deletedcookie/shek/shek_l/plots/shek-B_Fab.pdf

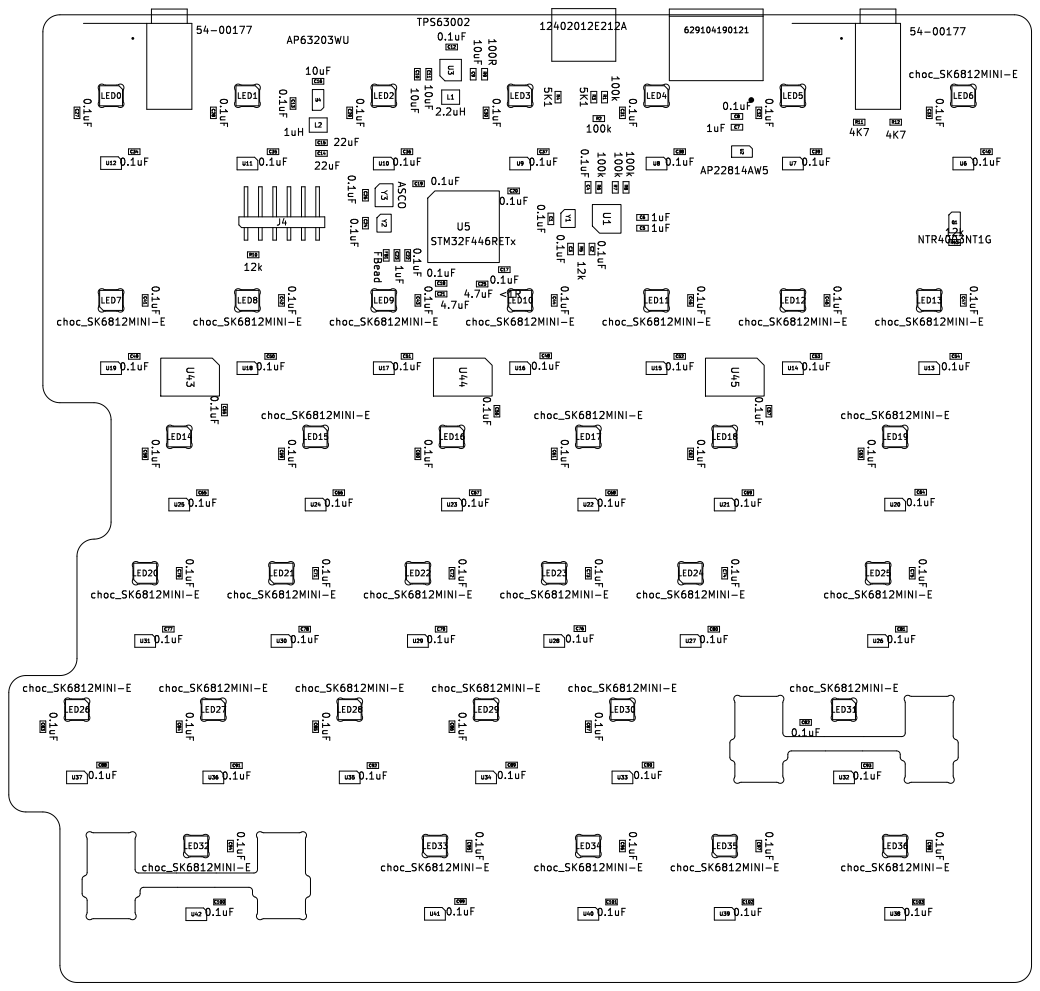
[picture p1: page 1]
