deletedcookie/shek/shek_r/plots/shek-rounded-B_Fab.pdf

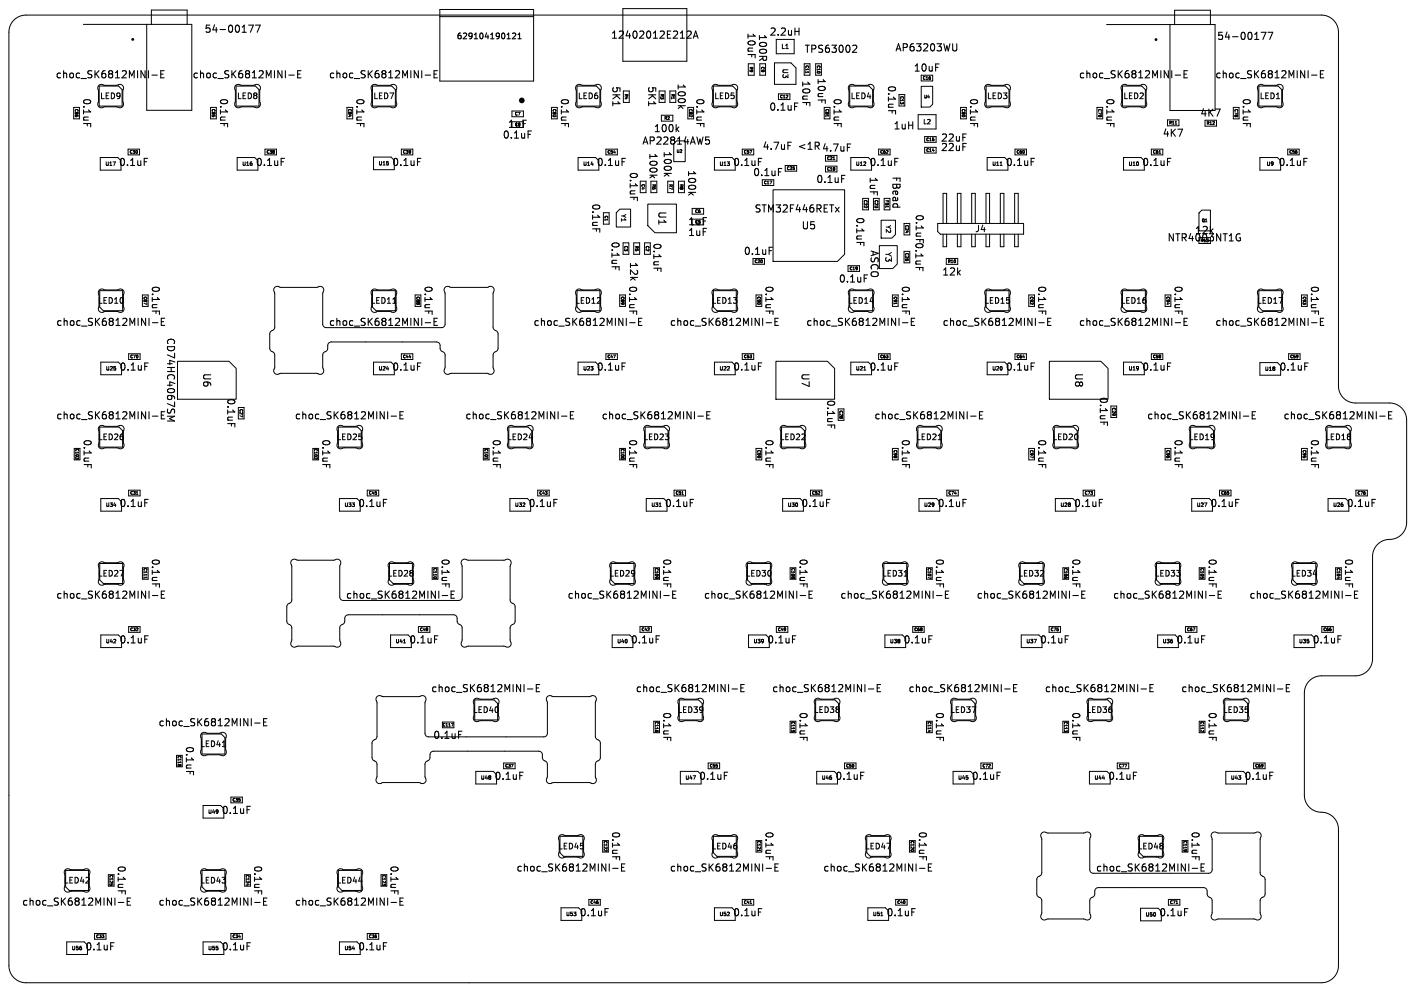
[picture p2: page 1]
