deletedcookie/shek/shek_r/plots/shek-rounded-Edge_Cuts.pdf

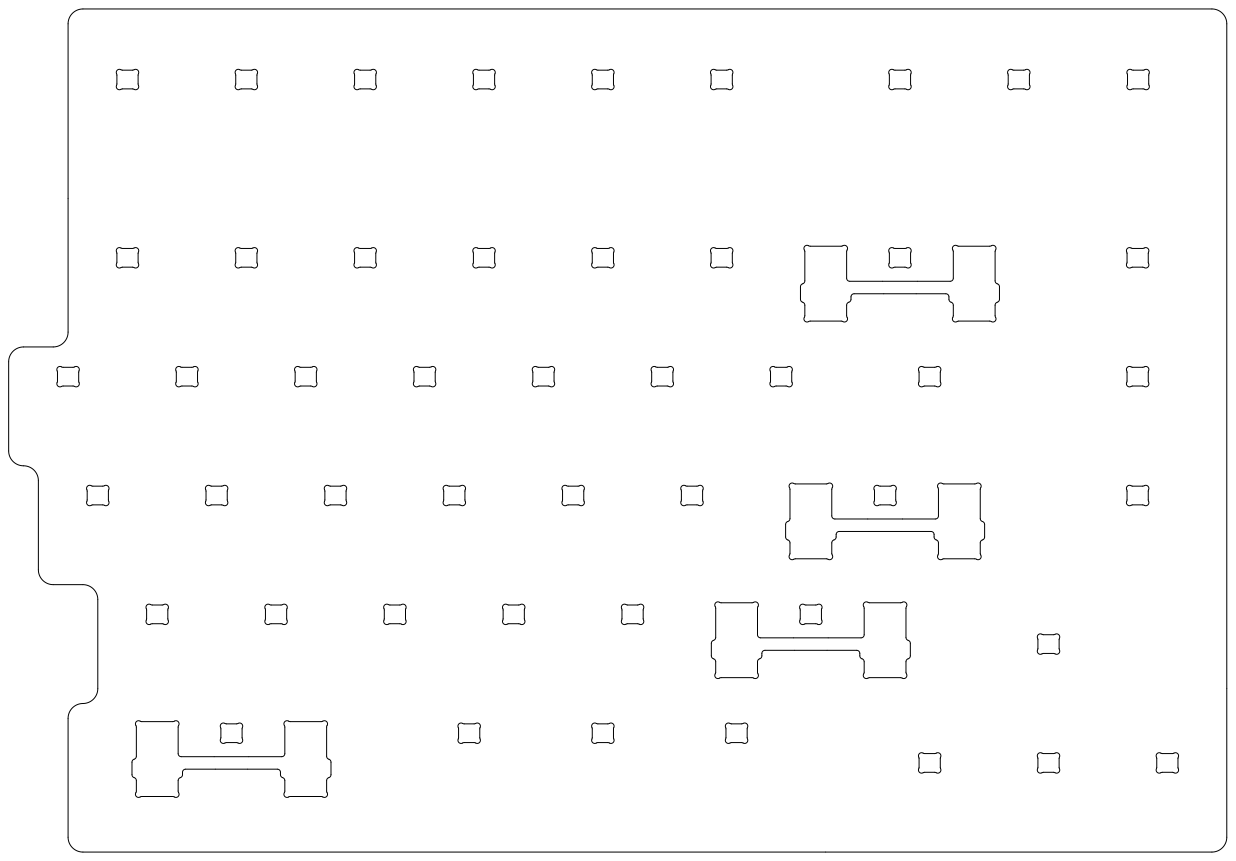
[picture p3: page 1]
