deletedcookie/shek/shek_l/shek.kicad_pcb

## KiCad design shek_l/shek.kicad_pcb (2025-09-28)

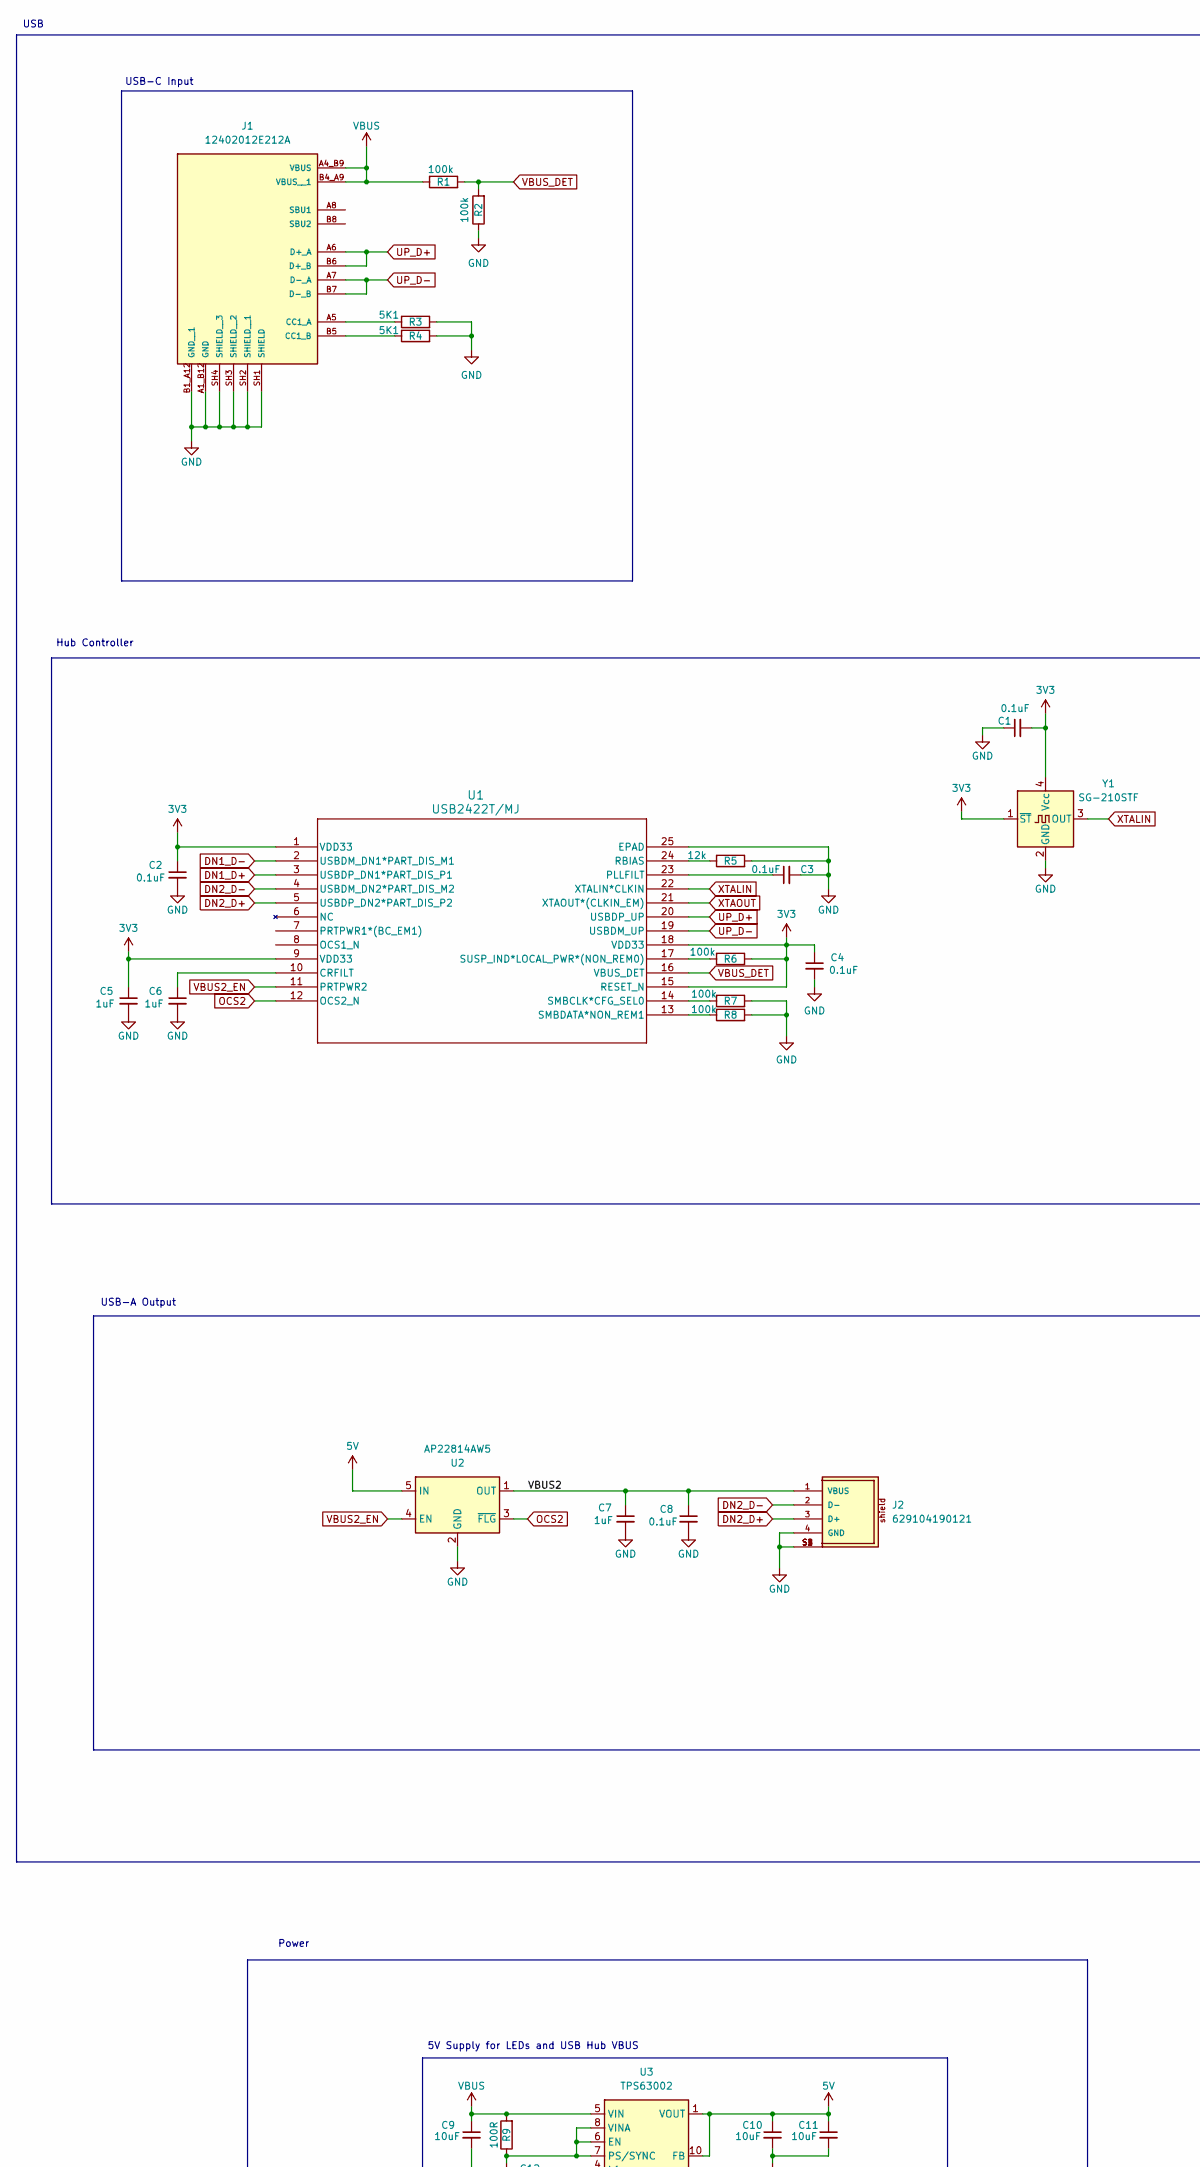
[picture p4: schematic shek.kicad_sch, part in row 1, column 1]

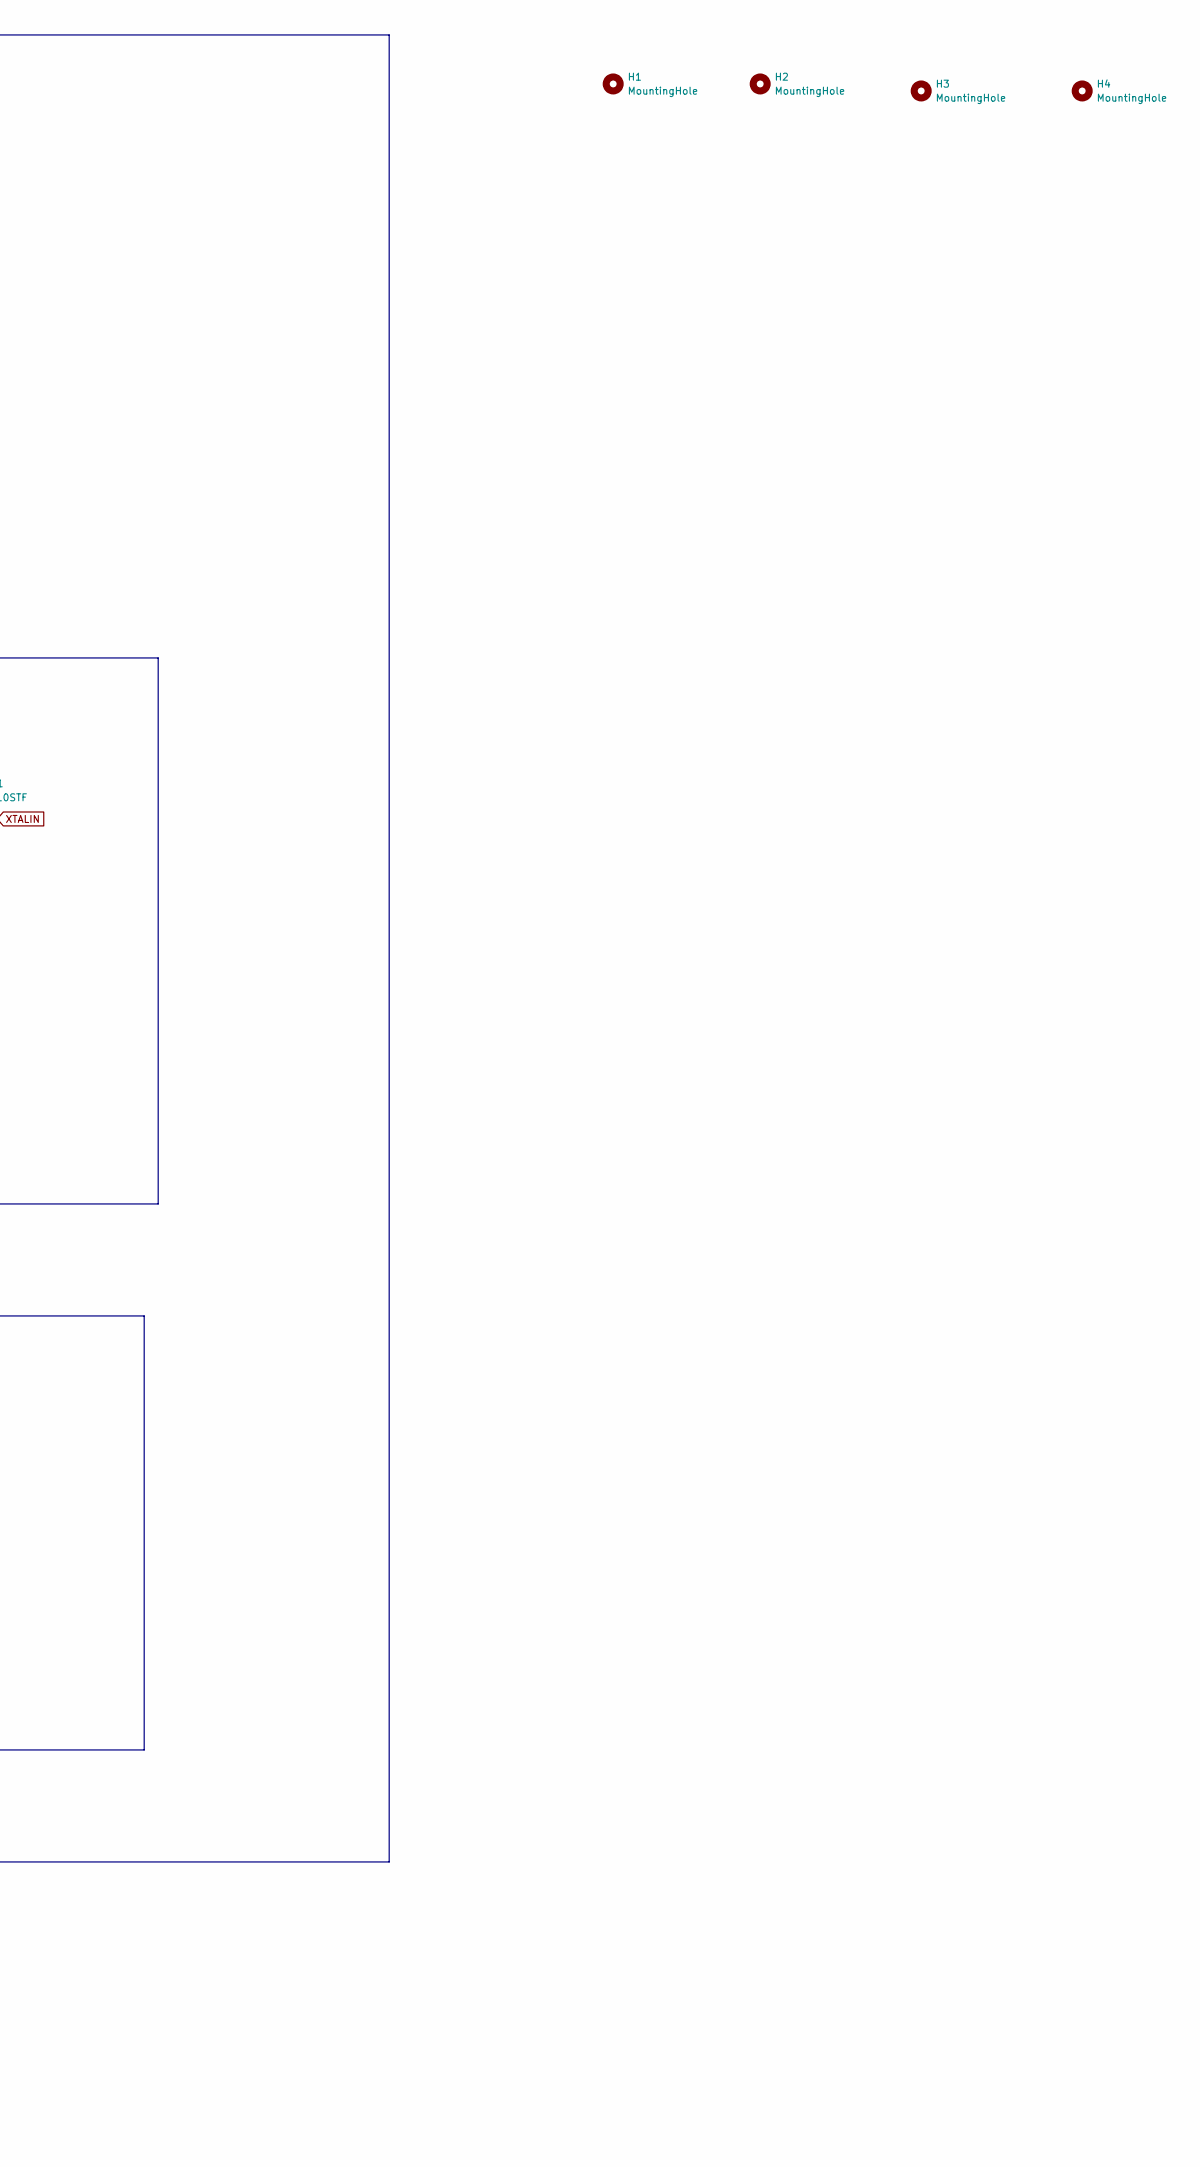
[picture p5: schematic shek.kicad_sch, part in row 1, column 2]

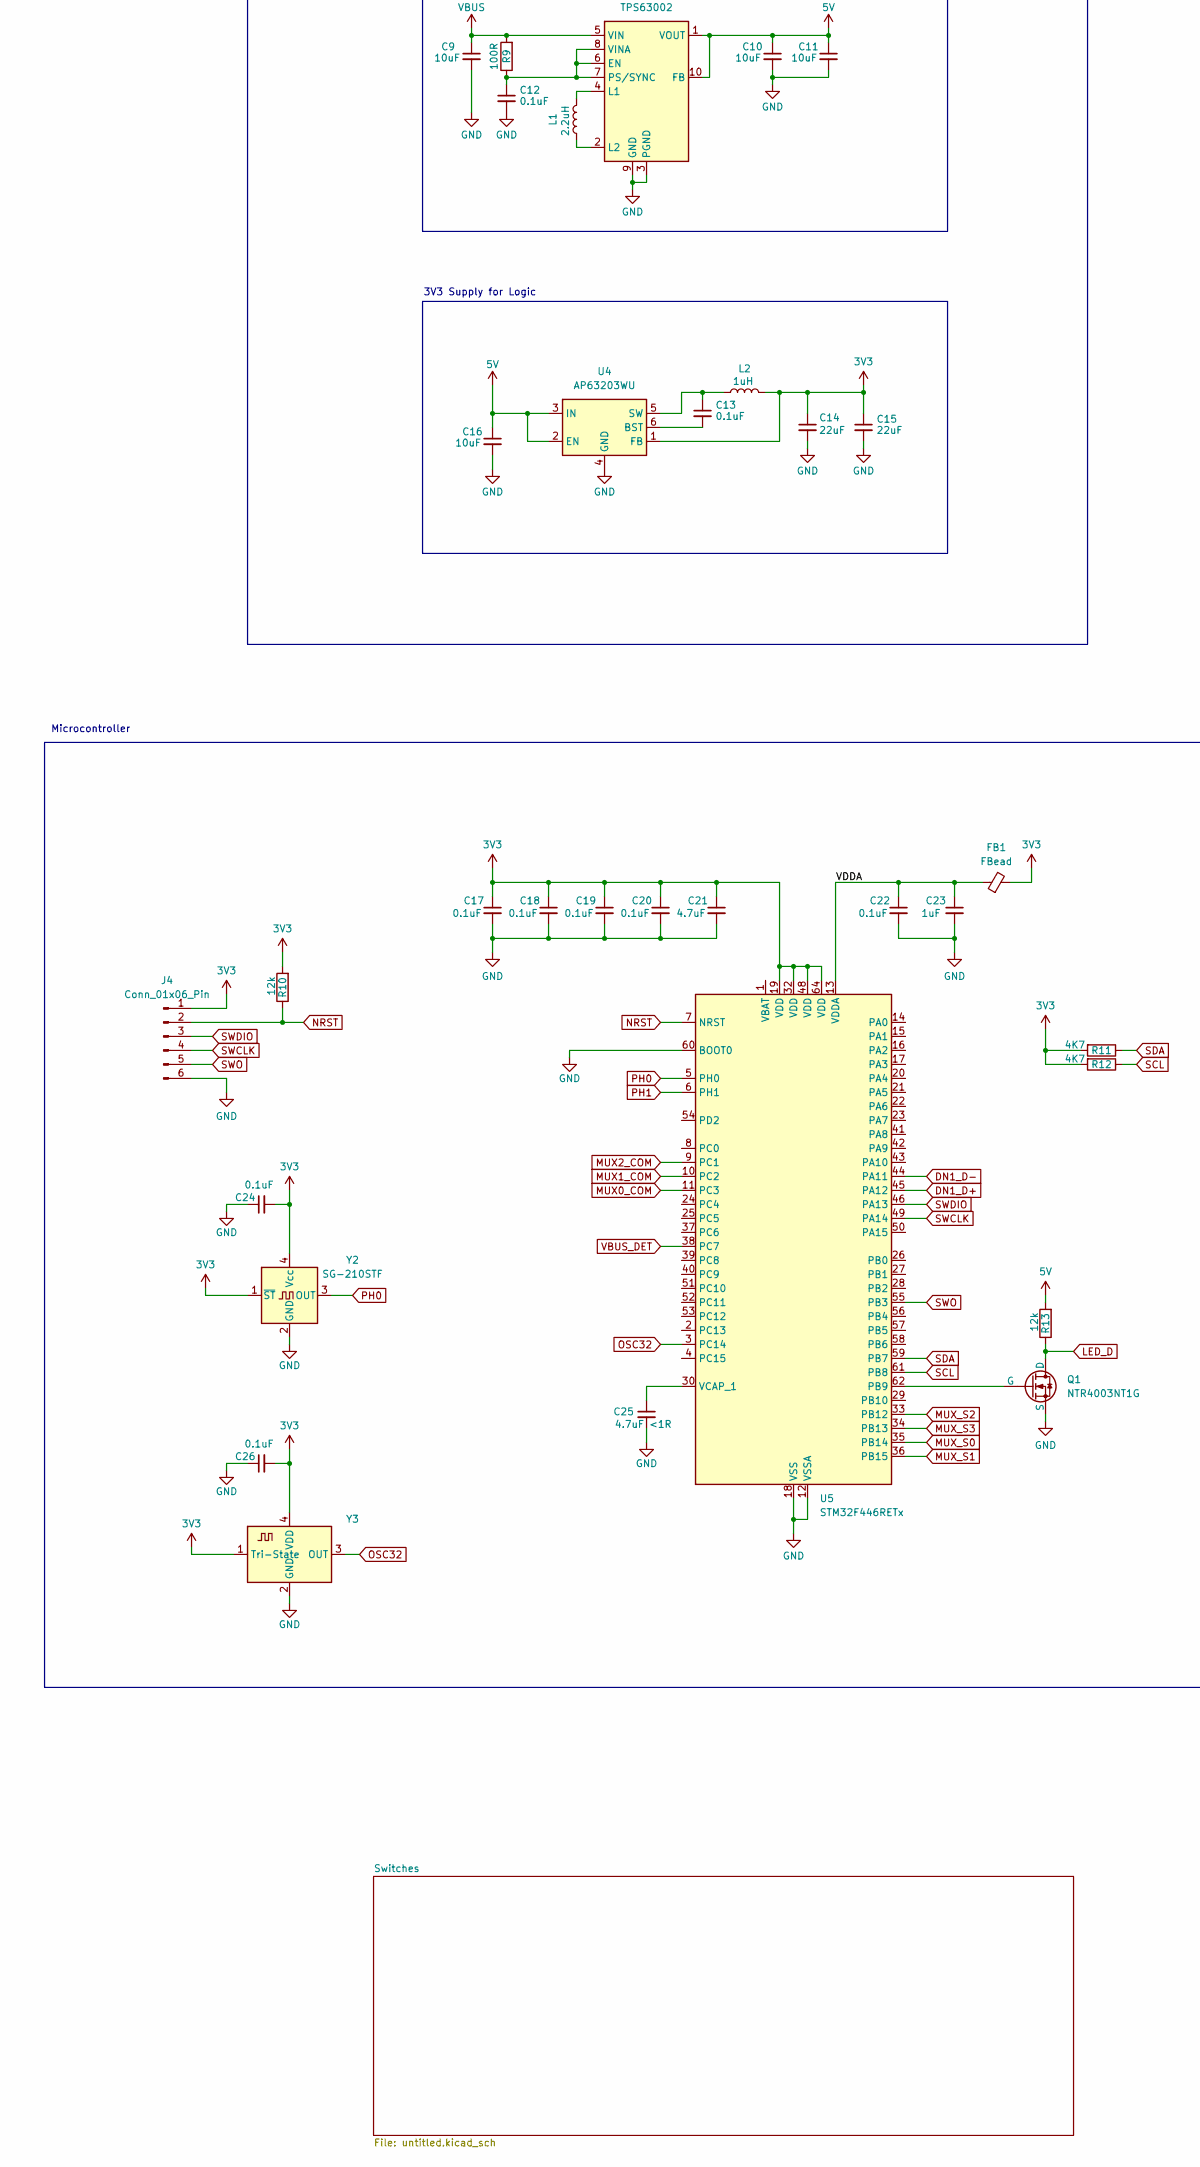
[picture p6: schematic shek.kicad_sch, part in row 2, column 1]

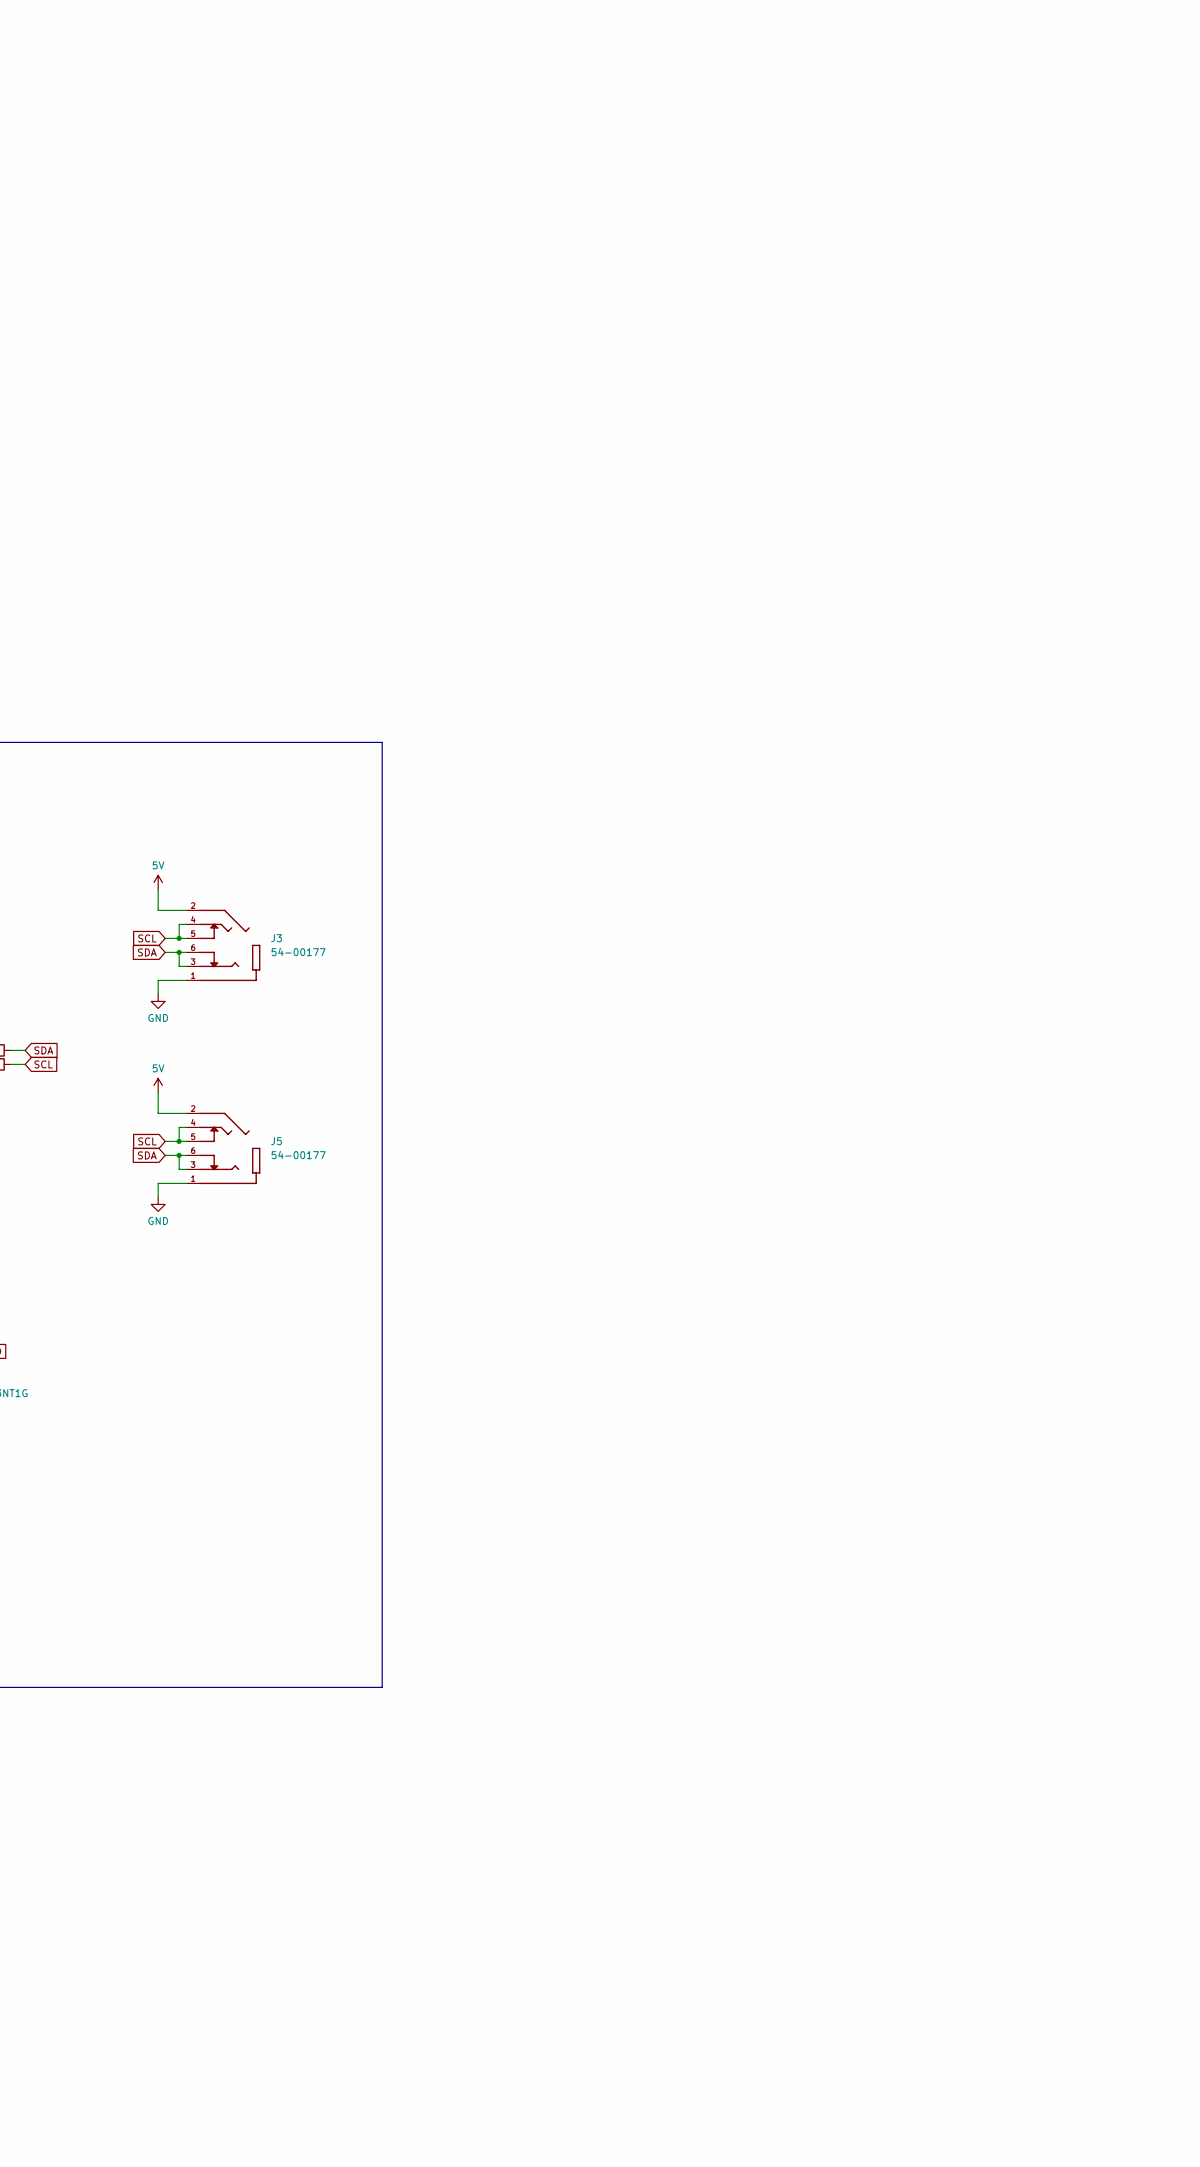
[picture p7: schematic shek.kicad_sch, part in row 2, column 2]

Parts:
C1, C2, C3, C4, C8, C12, C13, C17, C18, C19, C20, C22, C24, C26: 0.1uF; C_0603_1608Metric; Digikey 311-1088-1-ND
C5, C6, C7, C23: 1uF; C_0603_1608Metric; Digikey 311-1445-1-ND
C9, C10, C11, C16: 10uF; C_0603_1608Metric; Digikey 311-1817-1-ND
C14, C15: 22uF; C_0603_1608Metric; Digikey 490-10476-1-ND
C21: 4.7uF; C_0603_1608Metric; Digikey 311-1785-1-ND
C25: 4.7uF <1R; C_0603_1608Metric; Digikey 311-1785-1-ND
FB1: FBead; L_0603_1608Metric; Digikey 240-2558-1-ND
H1, H2, H3, H4: MountingHole; MountingHole_3.2mm_M3
J1: 12402012E212A; AMPHENOL_12402012E212A; PARTREV 4; Digikey 664-12402012E212ACT-ND
J2: 629104190121
J3, J5: 54-00177; TENSILITY_54-00177; PARTREV A; Digikey 839-54-00177CT-ND
J4: Conn_01x06_Pin; PinHeader_1x06_P2.00mm_Horizontal
L1: 2.2uH; L_1008_2520Metric; Digikey 490-13055-1-ND
L2: 1uH; L_1008_2520Metric; Digikey 490-13053-1-ND
Q1: NTR4003NT1G; SOT-23-3; Digikey NTR4003NT1GOSCT-ND
R1, R2, R6, R7, R8: 100k; R_0603_1608Metric; Digikey RG16P100KBCT-ND
R3, R4: 5K1; R_0603_1608Metric; Digikey RG16P5.1KBCT-ND
R5, R10, R13: 12k; R_0603_1608Metric; Digikey RG16P12.0KBCT-ND
R9: 100R; R_0603_1608Metric; Digikey RG16P100BCT-ND
R11, R12: 4K7; R_0603_1608Metric; Digikey RG16P4.7KBCT-ND
U1: USB2422T/MJ; HVQFN-24-1EP_4x4mm_P0.5mm_EP2.5x2.5mm; Digikey USB2422T/MJCT-ND
U2: AP22814AW5; SOT-23-5; Digikey AP22814AW5-7DICT-ND
U3: TPS63002; Texas_DRC0010J; Digikey 296-19644-1-ND
U4: AP63203WU; TSOT-23-6; Digikey AP63203WU-7DICT-ND
U5: STM32F446RETx; LQFP-64_10x10mm_P0.5mm; Digikey 497-STM32F446RET6TRCT-ND
Y1, Y2: SG-210STF; Oscillator_SMD_SeikoEpson_SG210-4Pin_2.5x2.0mm; Digikey SER4078CT-ND
Y3: ASCO; Crystal_SMD_Abracon_ABM8G-4Pin_3.2x2.5mm_silkmod; Digikey 535-ASEK-32.768KHZ-L-R-TCT-ND

Connections:
3V3: C1.2, C2.1, C4.1, C5.1, C14.1, C15.1, C17.1, C18.1, C19.1, C20.1, C21.1, C24.2, C26.2, FB1.2, J4.1, L2.2, R6.1, R10.2, R11.2, R12.2, U1.1 (VDD33), U1.9 (VDD33), U1.15 (RESET_N), U1.18 (VDD33), U4.1 (FB), U5.19 (VDD), U5.32 (VDD), U5.48 (VDD), U5.64 (VDD), Y1.1 (~ST), Y1.4 (Vcc), Y2.1 (~ST), Y2.4 (Vcc), Y3.1 (Tri-State), Y3.4 (VDD); also elsewhere on the board
5V: C10.1, C11.1, C16.1, J3.2, J5.2, R13.2, U2.5 (IN), U3.1 (VOUT), U3.10 (FB), U4.2 (EN), U4.3 (IN); also elsewhere on the board
/VBUS2: C7.1, C8.1, J2.1 (VBUS), U2.1 (OUT)
/VDDA: C22.1, C23.1, FB1.1, U5.13 (VDDA)
DN1_D+: U1.3 (USBDP_DN1*PART_DIS_P1), U5.45 (PA12)
DN1_D-: U1.2 (USBDM_DN1*PART_DIS_M1), U5.44 (PA11)
DN2_D+: J2.3 (D+), U1.5 (USBDP_DN2*PART_DIS_P2)
DN2_D-: J2.2 (D-), U1.4 (USBDM_DN2*PART_DIS_M2)
GND: C1.1, C2.2, C3.2, C4.2, C5.2, C6.2, C7.2, C8.2, C9.2, C10.2, C11.2, C12.2, C14.2, C15.2, C16.2, C17.2, C18.2, C19.2, C20.2, C21.2, C22.2, C23.2, C24.1, C25.2, C26.1, J1.A1_B12 (GND), J1.B1_A12 (GND__1), J1.SH1 (SHIELD), J1.SH2 (SHIELD__1), J1.SH3 (SHIELD__2), J1.SH4 (SHIELD__3), J2.4 (GND), J2.S1, J2.S2, J2.S3, J2.S4, J3.1, J4.6, J5.1, Q1.2 (S), R2.1, R3.2, R4.2, R5.2, R7.2, R8.2, U1.25 (EPAD), U2.2 (GND), U3.3 (PGND), U3.9 (GND), U3.11 (PGND), U4.4 (GND), U5.12 (VSSA), U5.18 (VSS), U5.31 (VSS), U5.47 (VSS), U5.60 (BOOT0), U5.63 (VSS), Y1.2 (GND), Y2.2 (GND), Y3.2 (GND); also elsewhere on the board
LED_D: Q1.3 (D), R13.1; also elsewhere on the board
MUX0_COM: U5.11 (PC3); also elsewhere on the board
MUX1_COM: U5.10 (PC2); also elsewhere on the board
MUX2_COM: U5.9 (PC1); also elsewhere on the board
MUX_S0: U5.35 (PB14); also elsewhere on the board
MUX_S1: U5.36 (PB15); also elsewhere on the board
MUX_S2: U5.33 (PB12); also elsewhere on the board
MUX_S3: U5.34 (PB13); also elsewhere on the board
NRST: J4.2, R10.1, U5.7 (NRST)
unnamed: J1.A5 (CC1_A), R3.1
unnamed: J1.B5 (CC1_B), R4.1
unnamed: Q1.1 (G), U5.62 (PB9)
unnamed: C6.1, U1.10 (CRFILT)
unnamed: C3.1, U1.23 (PLLFILT)
unnamed: R5.1, U1.24 (RBIAS)
unnamed: R7.1, U1.14 (SMBCLK*CFG_SEL0)
unnamed: R8.1, U1.13 (SMBDATA*NON_REM1)
unnamed: R6.2, U1.17 (SUSP_IND*LOCAL_PWR*(NON_REM0))
unnamed: C12.1, R9.1, U3.6 (EN), U3.7 (PS/SYNC), U3.8 (VINA)
unnamed: L1.2, U3.4 (L1)
unnamed: L1.1, U3.2 (L2)
unnamed: C13.2, U4.6 (BST)
unnamed: C13.1, L2.1, U4.5 (SW)
unnamed: C25.1, U5.30 (VCAP_1)
OCS2: U1.12 (OCS2_N), U2.3 (~FLG)
OSC32: U5.3 (PC14), Y3.3 (OUT)
PH0: U5.5 (PH0), Y2.3 (OUT)
PH1: U5.6 (PH1)
SCL: J3.4, J3.5, J5.4, J5.5, R12.1, U5.61 (PB8)
SDA: J3.3, J3.6, J5.3, J5.6, R11.1, U5.59 (PB7)
SWCLK: J4.4, U5.49 (PA14)
SWDIO: J4.3, U5.46 (PA13)
SWO: J4.5, U5.55 (PB3)
UP_D+: J1.A6 (D+_A), J1.B6 (D+_B), U1.20 (USBDP_UP)
UP_D-: J1.A7 (D-_A), J1.B7 (D-_B), U1.19 (USBDM_UP)
VBUS: C9.1, J1.A4_B9 (VBUS), J1.B4_A9 (VBUS__1), R1.1, R9.2, U3.5 (VIN)
VBUS2_EN: U1.11 (PRTPWR2), U2.4 (EN)
VBUS_DET: R1.2, R2.2, U1.16 (VBUS_DET), U5.38 (PC7)
XTALIN: U1.22 (XTALIN*CLKIN), Y1.3 (OUT)
XTAOUT: U1.21 (XTAOUT*(CLKIN_EM))

Notes on the sheet:
USB
USB-A Output
Microcontroller
3V3 Supply for Logic
Power
5V Supply for LEDs and USB Hub VBUS
USB-C Input
Hub Controller
