deletedcookie/shek/shek_l/shek.kicad_pcb

## KiCad design shek_l/shek.kicad_pcb (continued)

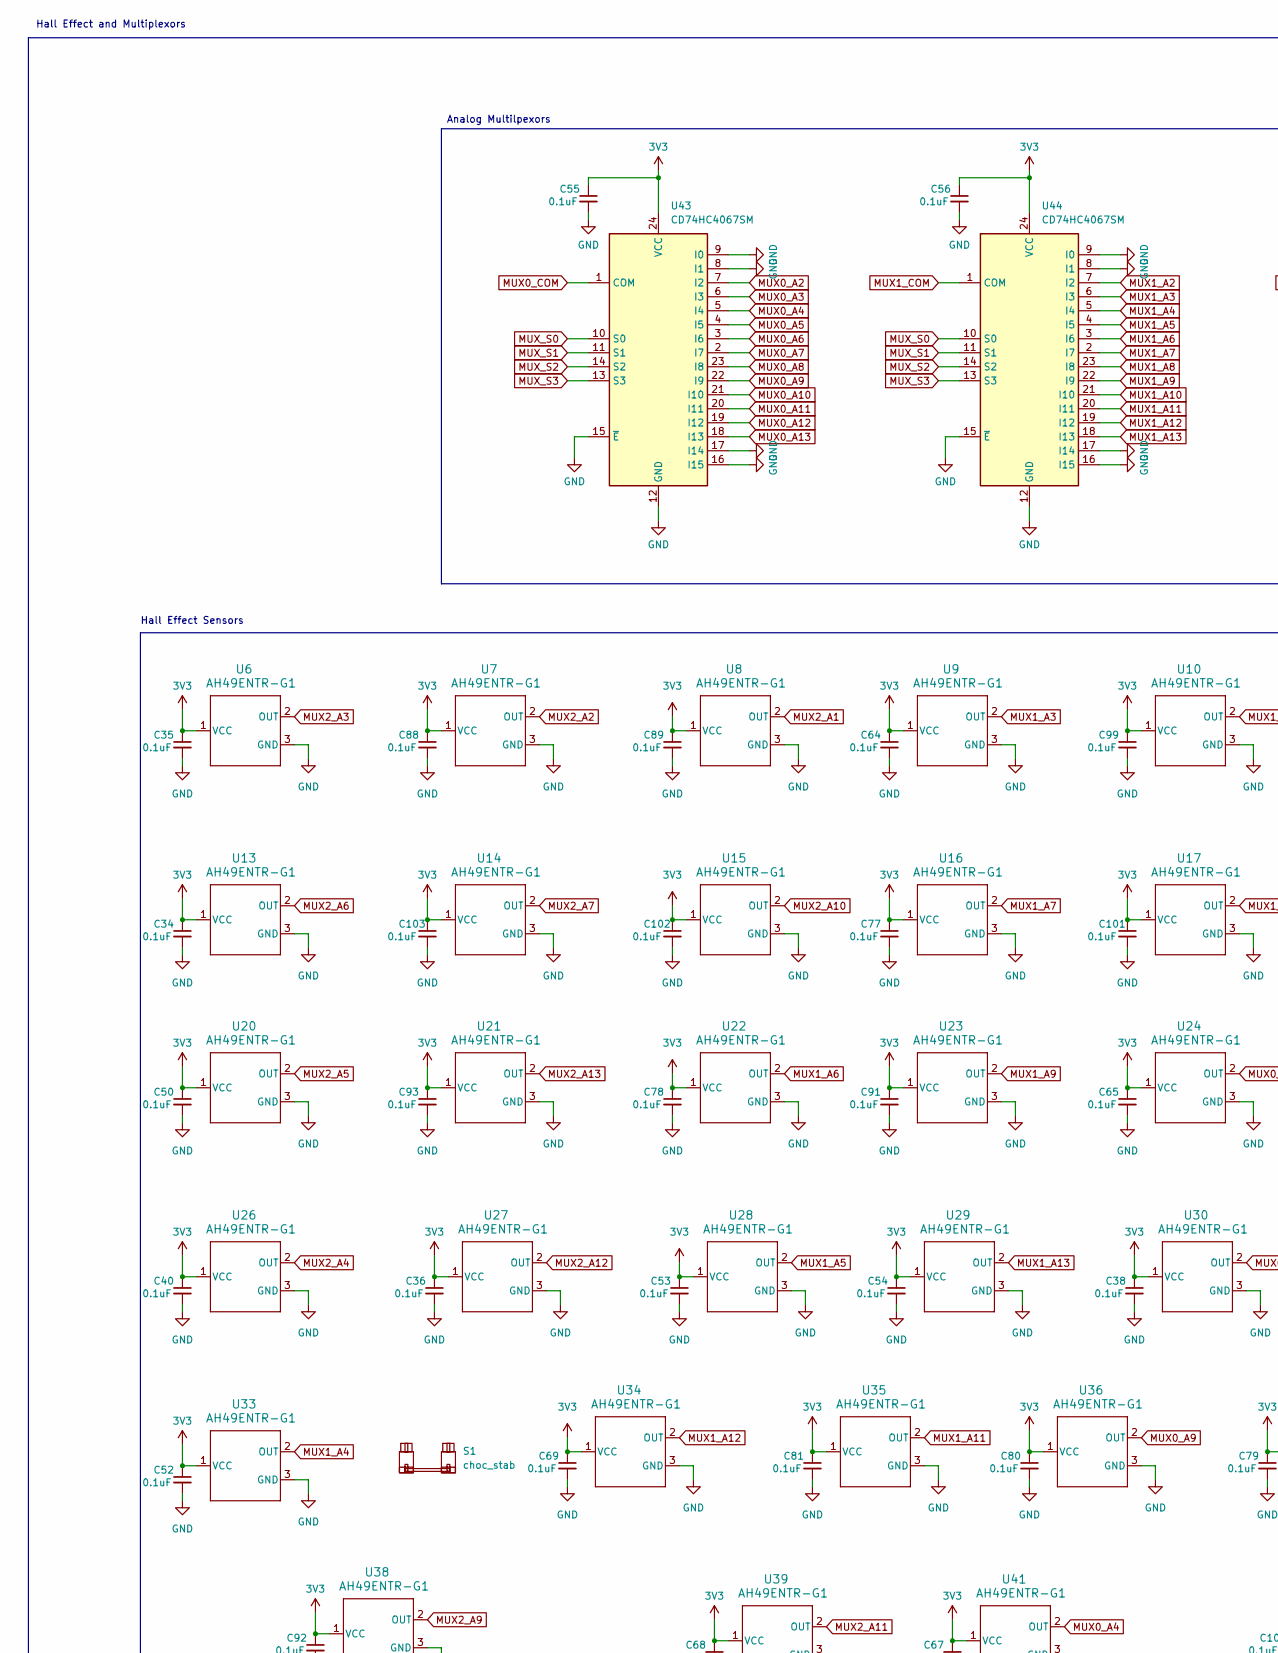
[picture p8: schematic untitled.kicad_sch, part in row 1, column 1]

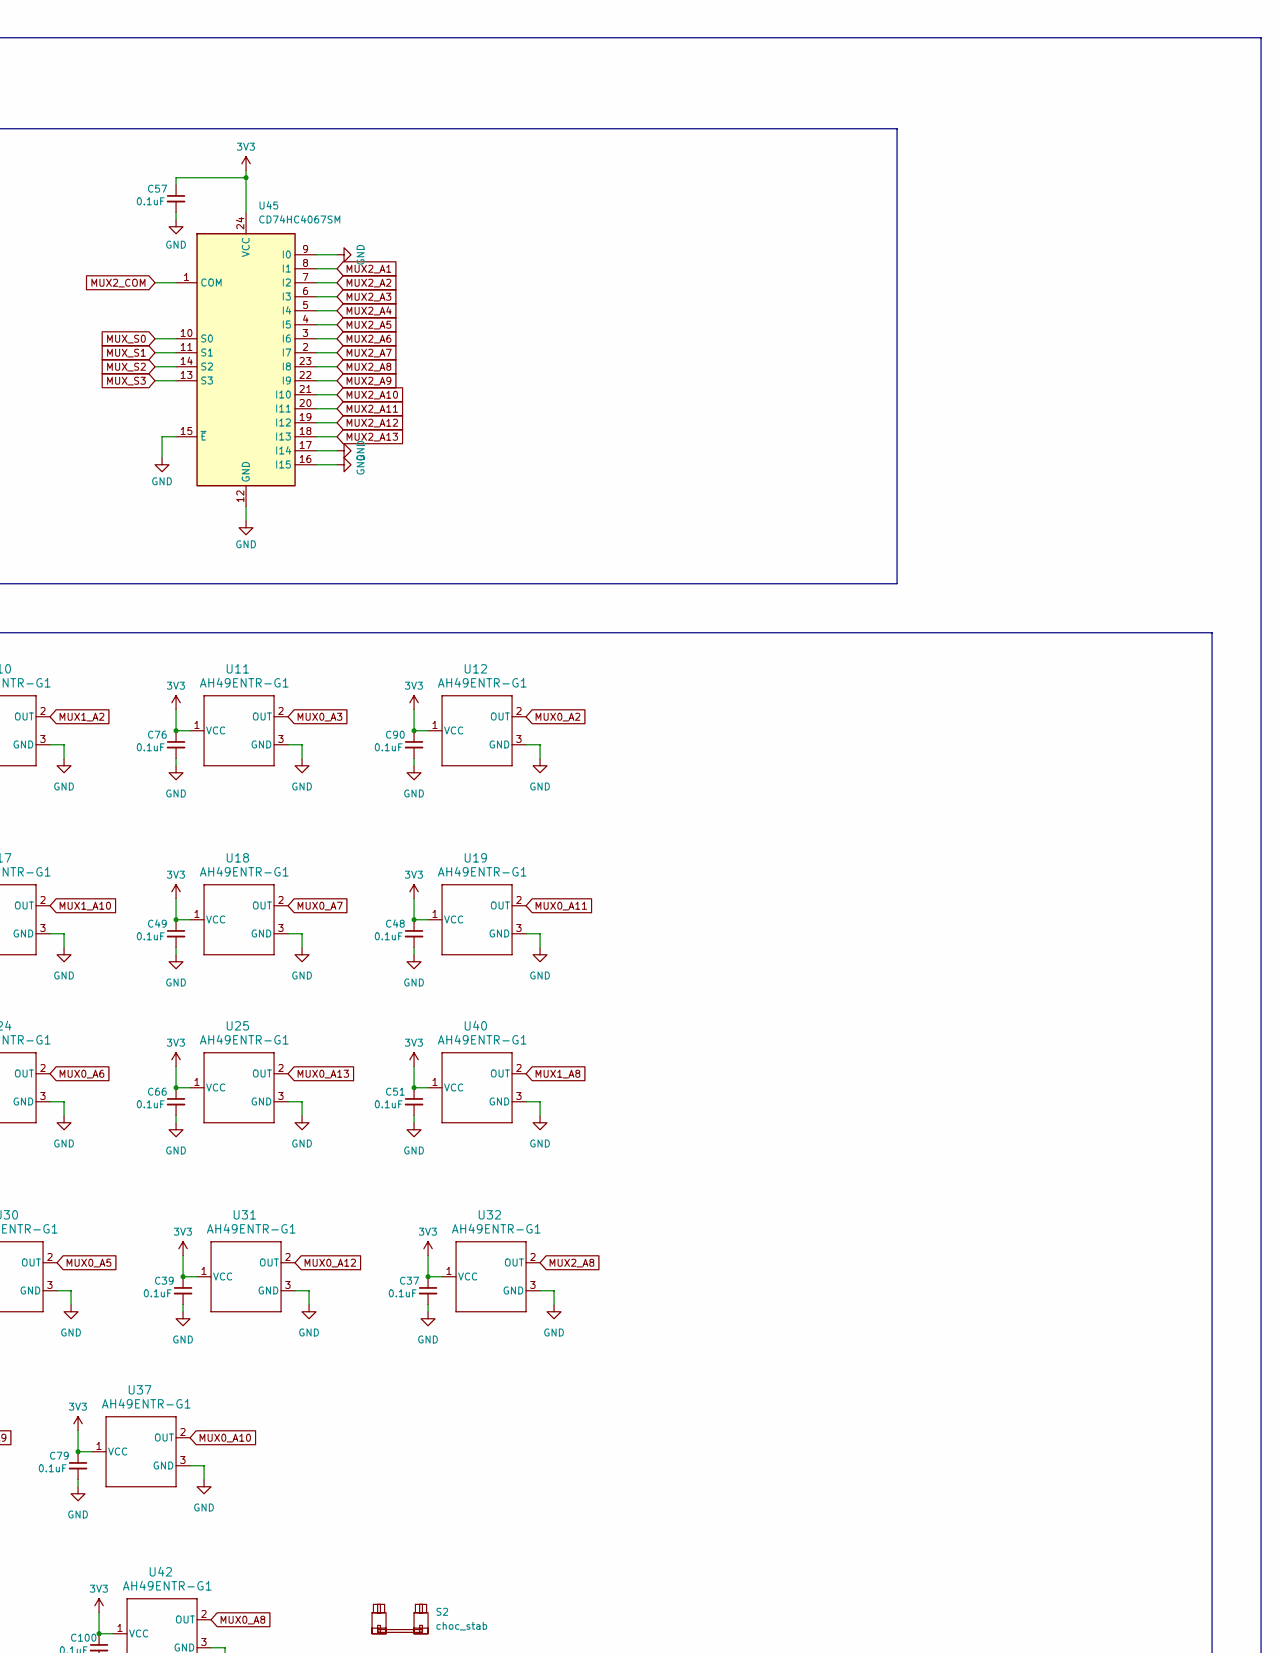
[picture p9: schematic untitled.kicad_sch, part in row 1, column 2]

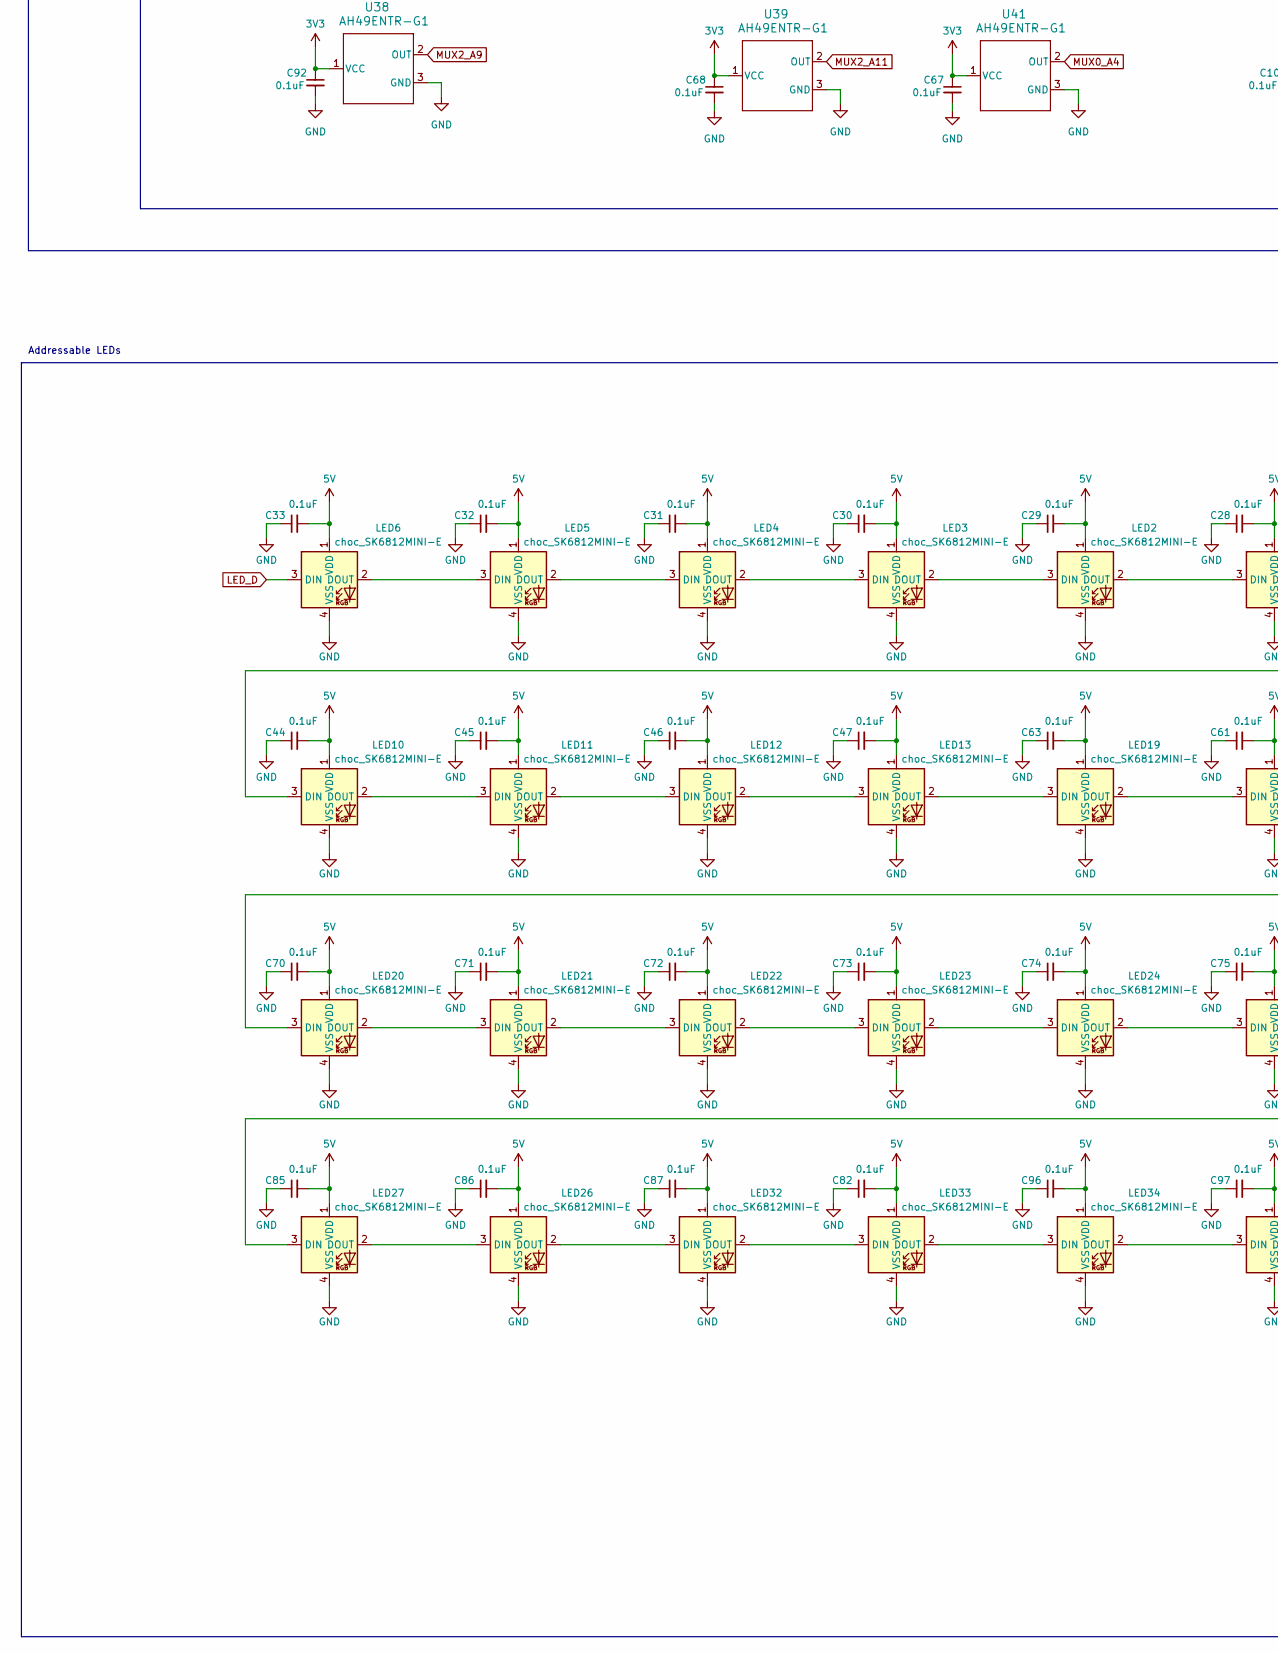
[picture p10: schematic untitled.kicad_sch, part in row 2, column 1]

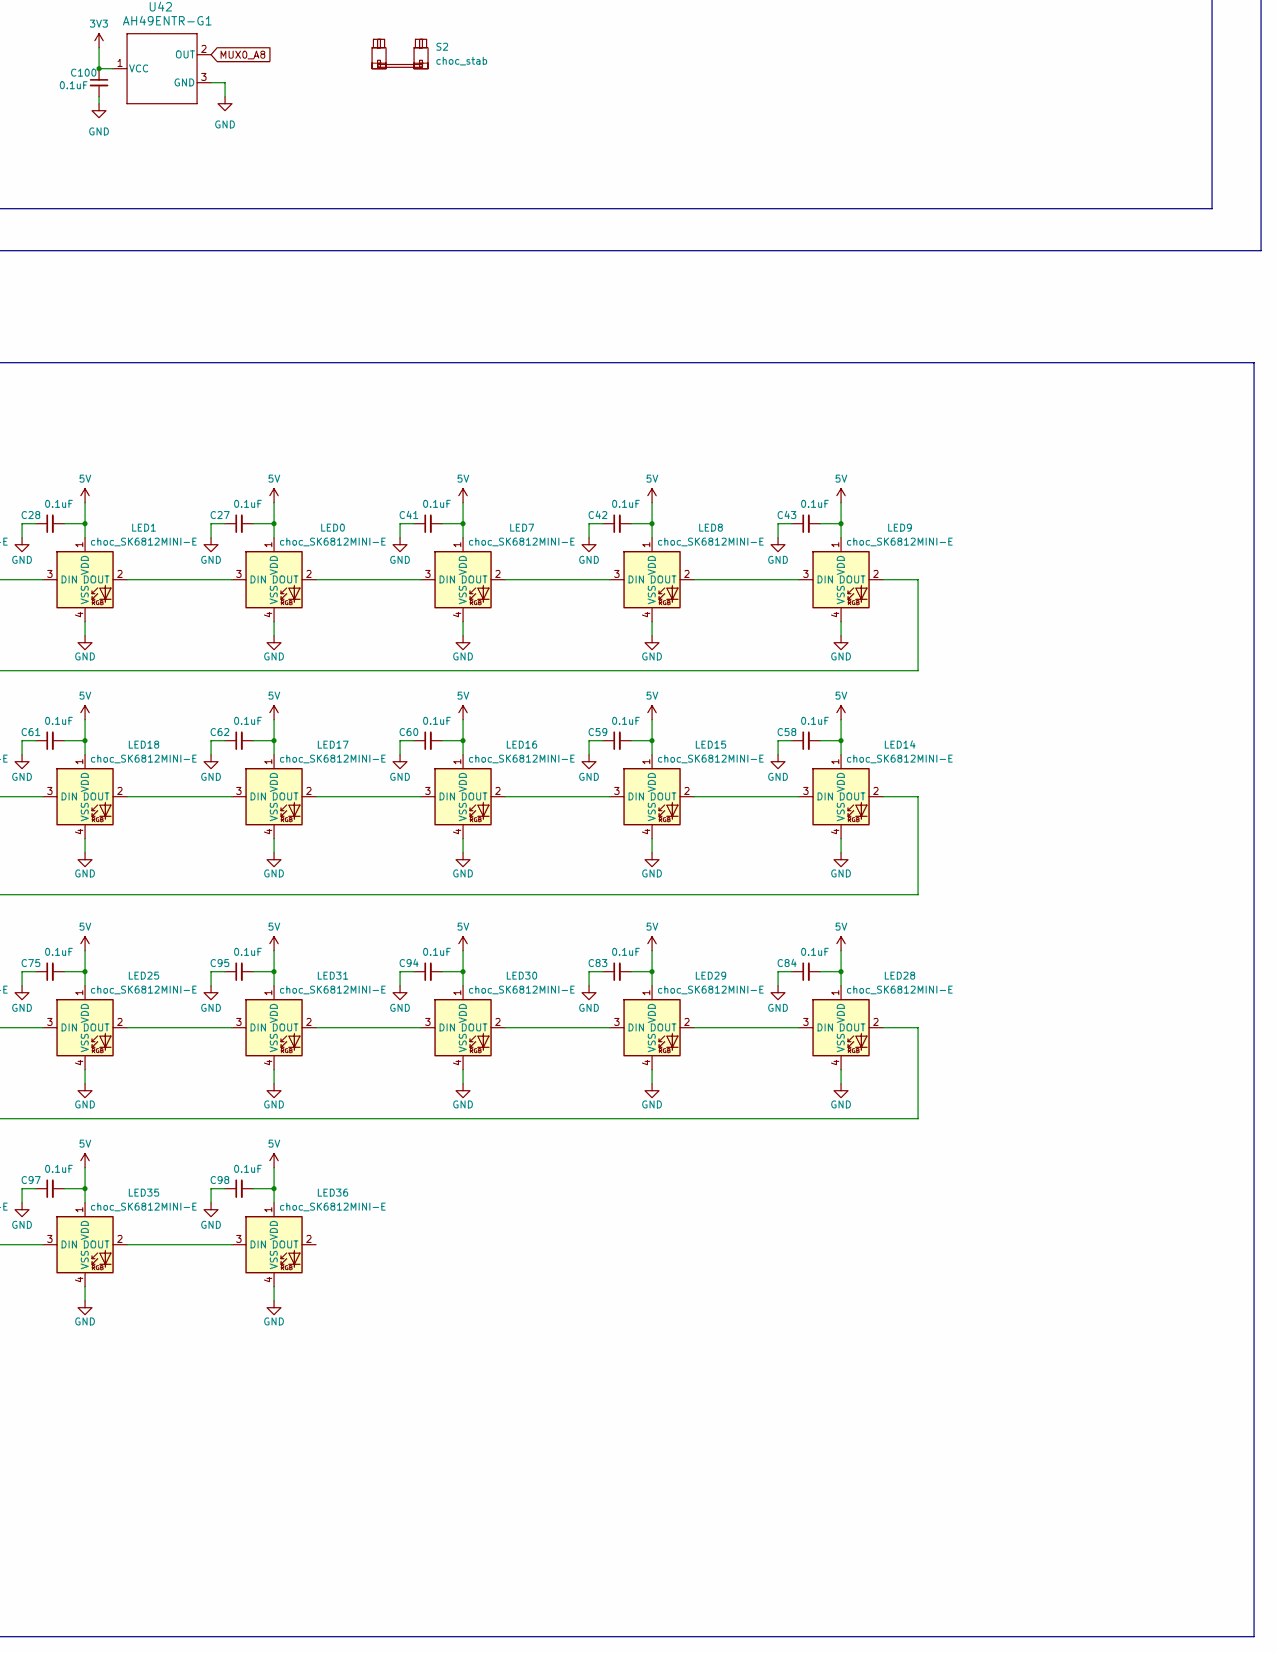
[picture p11: schematic untitled.kicad_sch, part in row 2, column 2]

Parts:
C27, C28, C29, C30, C31, C32, C33, C34, C35, C36, C37, C38, C39, C40, C41, C42, C43, C44, C45, C46, C47, C48, C49, C50, C51, C52, C53, C54, C55, C56, C57, C58, C59, C60, C61, C62, C63, C64, C65, C66, C67, C68, C69, C70, C71, C72, C73, C74, C75, C76, C77, C78, C79, C80, C81, C82, C83, C84, C85, C86, C87, C88, C89, C90, C91, C92, C93, C94, C95, C96, C97, C98, C99, C100, C101, C102, C103: 0.1uF; C_0603_1608Metric; Digikey 311-1088-1-ND
LED0, LED1, LED2, LED3, LED4, LED5, LED6, LED7, LED8, LED9, LED10, LED11, LED12, LED13, LED14, LED15, LED16, LED17, LED18, LED19, LED20, LED21, LED22, LED23, LED24, LED25, LED26, LED27, LED28, LED29, LED30, LED31, LED32, LED33, LED34, LED35, LED36: choc_SK6812MINI-E; LED_choc_6028R
S1, S2: choc_stab; Stabilizers_Plate-Mounted_2U
U6, U7, U8, U9, U10, U11, U12, U13, U14, U15, U16, U17, U18, U19, U21, U22, U23, U24, U25, U27, U28, U29, U30, U31, U32, U33, U34, U35, U36, U37, U39, U40, U42: AH49ENTR-G1; SOT-23-3_ChocV2-1U; Digikey AH49ENTR-G1DICT-ND
U20, U38: AH49ENTR-G1; SOT-23-3_ChocV2-1.5U; Digikey AH49ENTR-G1DICT-ND
U26: AH49ENTR-G1; SOT-23-3_ChocV2-1.75U; Digikey AH49ENTR-G1DICT-ND
U41: AH49ENTR-G1; SOT-23-3_ChocV2-1.25U; Digikey AH49ENTR-G1DICT-ND
U43, U44, U45: CD74HC4067SM; SSOP-24_5.3x8.2mm_P0.65mm; Digikey 1727-2807-1-ND

Connections:
3V3: C34.1, C35.1, C36.1, C37.1, C38.1, C39.1, C40.1, C48.1, C49.1, C50.1, C51.1, C52.1, C53.1, C54.1, C55.1, C56.1, C57.1, C64.1, C65.1, C66.1, C67.1, C68.1, C69.1, C76.1, C77.1, C78.1, C79.1, C80.1, C81.1, C88.1, C89.1, C90.1, C91.1, C92.1, C93.1, C99.1, C100.1, C101.1, C102.1, C103.1, U6.1 (VCC), U7.1 (VCC), U8.1 (VCC), U9.1 (VCC), U10.1 (VCC), U11.1 (VCC), U12.1 (VCC), U13.1 (VCC), U14.1 (VCC), U15.1 (VCC), U16.1 (VCC), U17.1 (VCC), U18.1 (VCC), U19.1 (VCC), U20.1 (VCC), U21.1 (VCC), U22.1 (VCC), U23.1 (VCC), U24.1 (VCC), U25.1 (VCC), U26.1 (VCC), U27.1 (VCC), U28.1 (VCC), U29.1 (VCC), U30.1 (VCC), U31.1 (VCC), U32.1 (VCC), U33.1 (VCC), U34.1 (VCC), U35.1 (VCC), U36.1 (VCC), U37.1 (VCC), U38.1 (VCC), U39.1 (VCC), U40.1 (VCC), U41.1 (VCC), U42.1 (VCC), U43.24 (VCC), U44.24 (VCC), U45.24 (VCC); also elsewhere on the board
5V: C27.2, C28.2, C29.2, C30.2, C31.2, C32.2, C33.2, C41.2, C42.2, C43.2, C44.2, C45.2, C46.2, C47.2, C58.2, C59.2, C60.2, C61.2, C62.2, C63.2, C70.2, C71.2, C72.2, C73.2, C74.2, C75.2, C82.2, C83.2, C84.2, C85.2, C86.2, C87.2, C94.2, C95.2, C96.2, C97.2, C98.2, LED0.1 (VDD), LED1.1 (VDD), LED2.1 (VDD), LED3.1 (VDD), LED4.1 (VDD), LED5.1 (VDD), LED6.1 (VDD), LED7.1 (VDD), LED8.1 (VDD), LED9.1 (VDD), LED10.1 (VDD), LED11.1 (VDD), LED12.1 (VDD), LED13.1 (VDD), LED14.1 (VDD), LED15.1 (VDD), LED16.1 (VDD), LED17.1 (VDD), LED18.1 (VDD), LED19.1 (VDD), LED20.1 (VDD), LED21.1 (VDD), LED22.1 (VDD), LED23.1 (VDD), LED24.1 (VDD), LED25.1 (VDD), LED26.1 (VDD), LED27.1 (VDD), LED28.1 (VDD), LED29.1 (VDD), LED30.1 (VDD), LED31.1 (VDD), LED32.1 (VDD), LED33.1 (VDD), LED34.1 (VDD), LED35.1 (VDD), LED36.1 (VDD); also elsewhere on the board
GND: C27.1, C28.1, C29.1, C30.1, C31.1, C32.1, C33.1, C34.2, C35.2, C36.2, C37.2, C38.2, C39.2, C40.2, C41.1, C42.1, C43.1, C44.1, C45.1, C46.1, C47.1, C48.2, C49.2, C50.2, C51.2, C52.2, C53.2, C54.2, C55.2, C56.2, C57.2, C58.1, C59.1, C60.1, C61.1, C62.1, C63.1, C64.2, C65.2, C66.2, C67.2, C68.2, C69.2, C70.1, C71.1, C72.1, C73.1, C74.1, C75.1, C76.2, C77.2, C78.2, C79.2, C80.2, C81.2, C82.1, C83.1, C84.1, C85.1, C86.1, C87.1, C88.2, C89.2, C90.2, C91.2, C92.2, C93.2, C94.1, C95.1, C96.1, C97.1, C98.1, C99.2, C100.2, C101.2, C102.2, C103.2, LED0.4 (VSS), LED1.4 (VSS), LED2.4 (VSS), LED3.4 (VSS), LED4.4 (VSS), LED5.4 (VSS), LED6.4 (VSS), LED7.4 (VSS), LED8.4 (VSS), LED9.4 (VSS), LED10.4 (VSS), LED11.4 (VSS), LED12.4 (VSS), LED13.4 (VSS), LED14.4 (VSS), LED15.4 (VSS), LED16.4 (VSS), LED17.4 (VSS), LED18.4 (VSS), LED19.4 (VSS), LED20.4 (VSS), LED21.4 (VSS), LED22.4 (VSS), LED23.4 (VSS), LED24.4 (VSS), LED25.4 (VSS), LED26.4 (VSS), LED27.4 (VSS), LED28.4 (VSS), LED29.4 (VSS), LED30.4 (VSS), LED31.4 (VSS), LED32.4 (VSS), LED33.4 (VSS), LED34.4 (VSS), LED35.4 (VSS), LED36.4 (VSS), U6.3 (GND), U7.3 (GND), U8.3 (GND), U9.3 (GND), U10.3 (GND), U11.3 (GND), U12.3 (GND), U13.3 (GND), U14.3 (GND), U15.3 (GND), U16.3 (GND), U17.3 (GND), U18.3 (GND), U19.3 (GND), U20.3 (GND), U21.3 (GND), U22.3 (GND), U23.3 (GND), U24.3 (GND), U25.3 (GND), U26.3 (GND), U27.3 (GND), U28.3 (GND), U29.3 (GND), U30.3 (GND), U31.3 (GND), U32.3 (GND), U33.3 (GND), U34.3 (GND), U35.3 (GND), U36.3 (GND), U37.3 (GND), U38.3 (GND), U39.3 (GND), U40.3 (GND), U41.3 (GND), U42.3 (GND), U43.8 (I1), U43.9 (I0), U43.12 (GND), U43.15 (~E), U43.16 (I15), U43.17 (I14), U44.8 (I1), U44.9 (I0), U44.12 (GND), U44.15 (~E), U44.16 (I15), U44.17 (I14), U45.9 (I0), U45.12 (GND), U45.15 (~E), U45.16 (I15), U45.17 (I14); also elsewhere on the board
LED_D: LED6.3 (DIN); also elsewhere on the board
MUX0_A2: U12.2 (OUT), U43.7 (I2)
MUX0_A3: U11.2 (OUT), U43.6 (I3)
MUX0_A4: U41.2 (OUT), U43.5 (I4)
MUX0_A5: U30.2 (OUT), U43.4 (I5)
MUX0_A6: U24.2 (OUT), U43.3 (I6)
MUX0_A7: U18.2 (OUT), U43.2 (I7)
MUX0_A8: U42.2 (OUT), U43.23 (I8)
MUX0_A9: U36.2 (OUT), U43.22 (I9)
MUX0_A10: U37.2 (OUT), U43.21 (I10)
MUX0_A11: U19.2 (OUT), U43.20 (I11)
MUX0_A12: U31.2 (OUT), U43.19 (I12)
MUX0_A13: U25.2 (OUT), U43.18 (I13)
MUX0_COM: U43.1 (COM); also elsewhere on the board
MUX1_A2: U10.2 (OUT), U44.7 (I2)
MUX1_A3: U9.2 (OUT), U44.6 (I3)
MUX1_A4: U33.2 (OUT), U44.5 (I4)
MUX1_A5: U28.2 (OUT), U44.4 (I5)
MUX1_A6: U22.2 (OUT), U44.3 (I6)
MUX1_A7: U16.2 (OUT), U44.2 (I7)
MUX1_A8: U40.2 (OUT), U44.23 (I8)
MUX1_A9: U23.2 (OUT), U44.22 (I9)
MUX1_A10: U17.2 (OUT), U44.21 (I10)
MUX1_A11: U35.2 (OUT), U44.20 (I11)
MUX1_A12: U34.2 (OUT), U44.19 (I12)
MUX1_A13: U29.2 (OUT), U44.18 (I13)
MUX1_COM: U44.1 (COM); also elsewhere on the board
MUX2_A1: U8.2 (OUT), U45.8 (I1)
MUX2_A2: U7.2 (OUT), U45.7 (I2)
MUX2_A3: U6.2 (OUT), U45.6 (I3)
MUX2_A4: U26.2 (OUT), U45.5 (I4)
MUX2_A5: U20.2 (OUT), U45.4 (I5)
MUX2_A6: U13.2 (OUT), U45.3 (I6)
MUX2_A7: U14.2 (OUT), U45.2 (I7)
MUX2_A8: U32.2 (OUT), U45.23 (I8)
MUX2_A9: U38.2 (OUT), U45.22 (I9)
MUX2_A10: U15.2 (OUT), U45.21 (I10)
MUX2_A11: U39.2 (OUT), U45.20 (I11)
MUX2_A12: U27.2 (OUT), U45.19 (I12)
MUX2_A13: U21.2 (OUT), U45.18 (I13)
MUX2_COM: U45.1 (COM); also elsewhere on the board
MUX_S0: U43.10 (S0), U44.10 (S0), U45.10 (S0); also elsewhere on the board
MUX_S1: U43.11 (S1), U44.11 (S1), U45.11 (S1); also elsewhere on the board
MUX_S2: U43.14 (S2), U44.14 (S2), U45.14 (S2); also elsewhere on the board
MUX_S3: U43.13 (S3), U44.13 (S3), U45.13 (S3); also elsewhere on the board
unnamed: LED5.3 (DIN), LED6.2 (DOUT)
unnamed: LED4.3 (DIN), LED5.2 (DOUT)
unnamed: LED3.3 (DIN), LED4.2 (DOUT)
unnamed: LED2.3 (DIN), LED3.2 (DOUT)
unnamed: LED1.3 (DIN), LED2.2 (DOUT)
unnamed: LED0.3 (DIN), LED1.2 (DOUT)
unnamed: LED0.2 (DOUT), LED7.3 (DIN)
unnamed: LED7.2 (DOUT), LED8.3 (DIN)
unnamed: LED8.2 (DOUT), LED9.3 (DIN)
unnamed: LED9.2 (DOUT), LED10.3 (DIN)
unnamed: LED10.2 (DOUT), LED11.3 (DIN)
unnamed: LED11.2 (DOUT), LED12.3 (DIN)
unnamed: LED12.2 (DOUT), LED13.3 (DIN)
unnamed: LED13.2 (DOUT), LED19.3 (DIN)
unnamed: LED18.3 (DIN), LED19.2 (DOUT)
unnamed: LED17.3 (DIN), LED18.2 (DOUT)
unnamed: LED16.3 (DIN), LED17.2 (DOUT)
unnamed: LED15.3 (DIN), LED16.2 (DOUT)
unnamed: LED14.3 (DIN), LED15.2 (DOUT)
unnamed: LED14.2 (DOUT), LED20.3 (DIN)
unnamed: LED20.2 (DOUT), LED21.3 (DIN)
unnamed: LED21.2 (DOUT), LED22.3 (DIN)
unnamed: LED22.2 (DOUT), LED23.3 (DIN)
unnamed: LED23.2 (DOUT), LED24.3 (DIN)
unnamed: LED24.2 (DOUT), LED25.3 (DIN)
unnamed: LED25.2 (DOUT), LED31.3 (DIN)
unnamed: LED30.3 (DIN), LED31.2 (DOUT)
unnamed: LED29.3 (DIN), LED30.2 (DOUT)
unnamed: LED28.3 (DIN), LED29.2 (DOUT)
unnamed: LED27.3 (DIN), LED28.2 (DOUT)
unnamed: LED26.3 (DIN), LED27.2 (DOUT)
unnamed: LED26.2 (DOUT), LED32.3 (DIN)
unnamed: LED32.2 (DOUT), LED33.3 (DIN)
unnamed: LED33.2 (DOUT), LED34.3 (DIN)
unnamed: LED34.2 (DOUT), LED35.3 (DIN)
unnamed: LED35.2 (DOUT), LED36.3 (DIN)

Notes on the sheet:
Hall Effect and Multiplexors
Analog Multilpexors
Addressable LEDs
Hall Effect Sensors

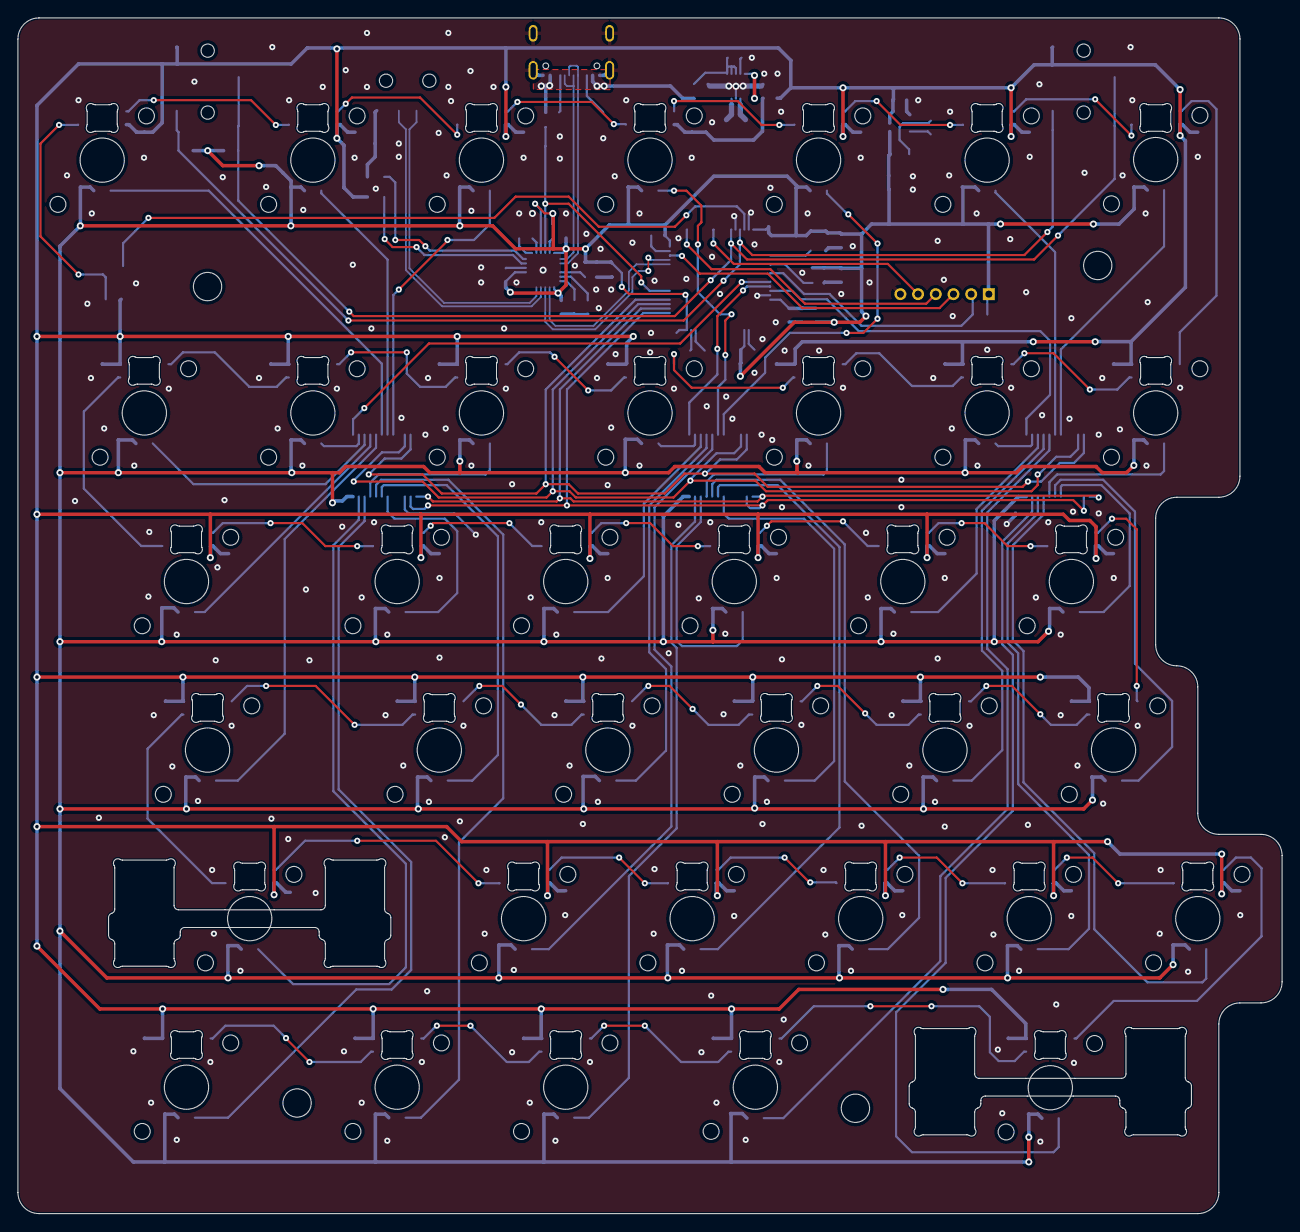
[picture p12: board shek.kicad_pcb from above]

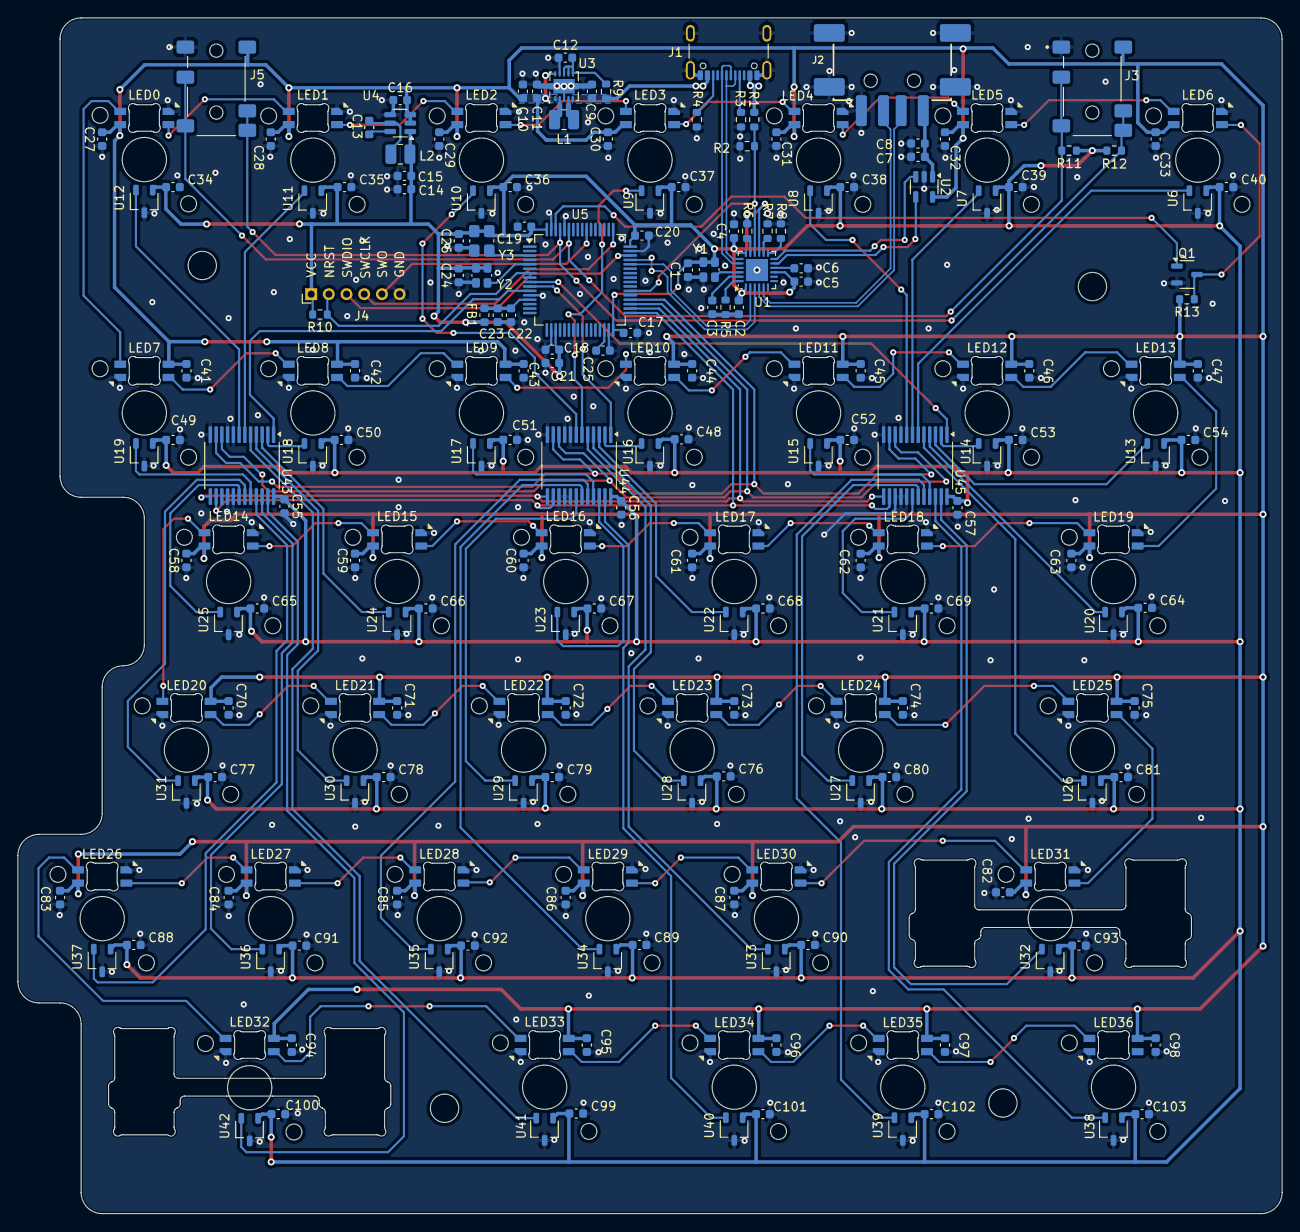
[picture p13: board shek.kicad_pcb from below]

Board: 2 copper layers, 142.9 x 135.1 mm, 216 parts (173 on the bottom side), 120 nets.
